mertpalabiyik/trotten-motorized/docs/images/button-caps.png

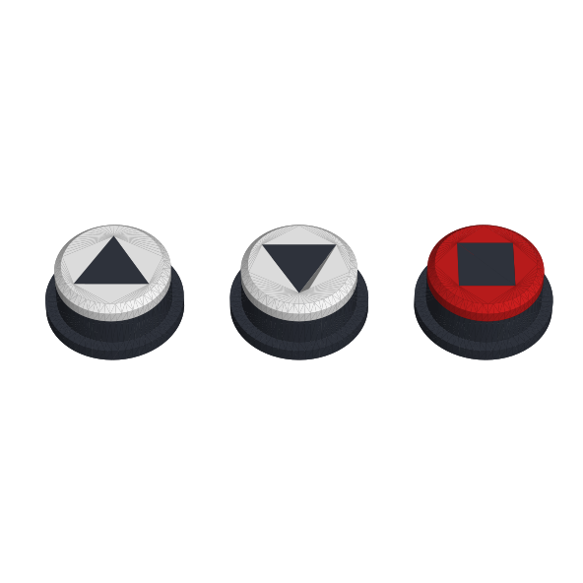
docs/images/button-caps.png
