mertpalabiyik/trotten-motorized/docs/images/coupler.png

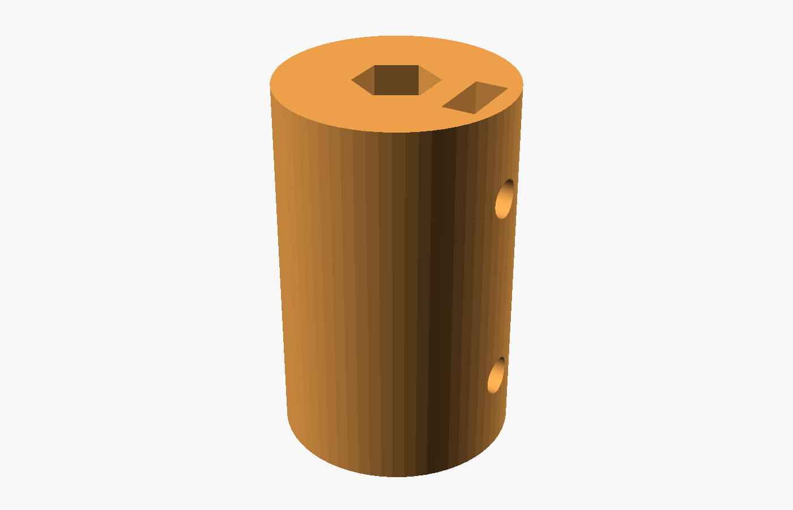
docs/images/coupler.png
