mertpalabiyik/trotten-motorized/docs/images/cover.png

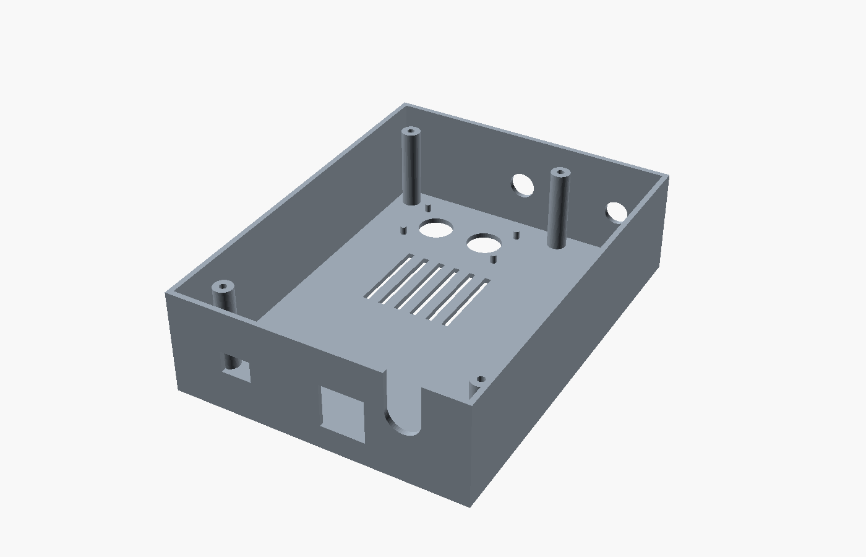
docs/images/cover.png
