mertpalabiyik/trotten-motorized/docs/images/hcsr04-spacer.png

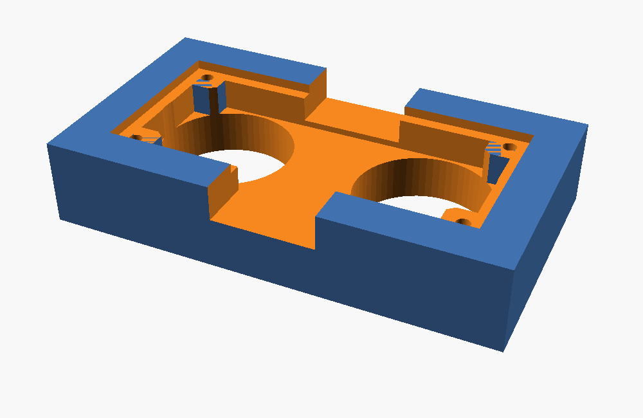
docs/images/hcsr04-spacer.png
