mertpalabiyik/trotten-motorized/cad/main-box/cover.stl

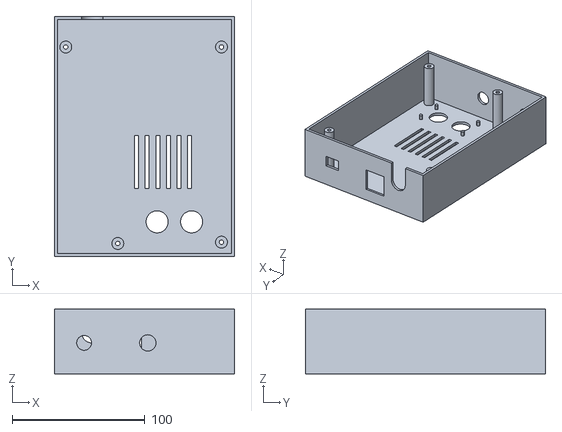
[picture p12: CAD file, 2026-10-15]
cad/main-box/cover.stl
135.8 x 180.8 x 48.9
