mertpalabiyik/trotten-motorized/cad/original/Body1.stl

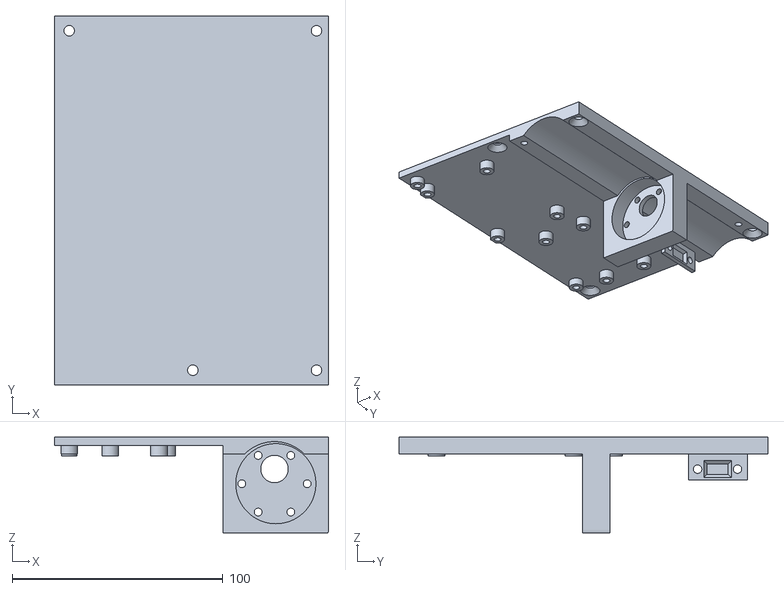
[picture p13: CAD file, 2026-10-14]
cad/original/Body1.stl
130.0 x 175.0 x 45.3
