mertpalabiyik/trotten-motorized/cad/panel/ams/button-caps-top-arrows.stl

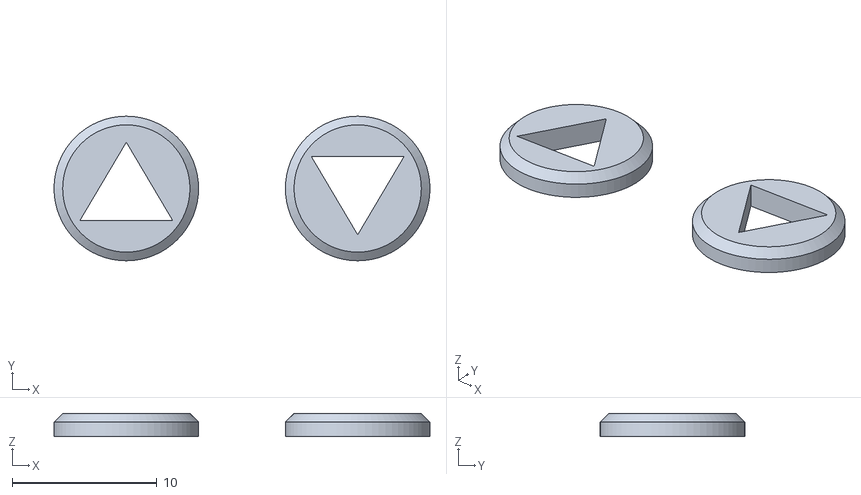
[picture p14: CAD file, 2026-10-14]
cad/panel/ams/button-caps-top-arrows.stl
26.0 x 10.0 x 1.60
