mertpalabiyik/trotten-motorized/cad/panel/panel-box.stl

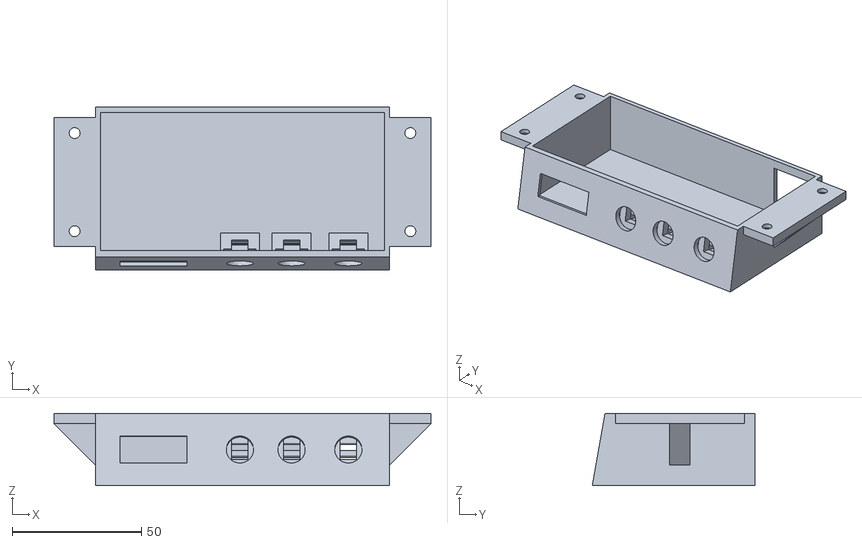
[picture p15: CAD file, 2026-10-15]
cad/panel/panel-box.stl
146.0 x 62.9 x 28.0
