mertpalabiyik/trotten-motorized/cad/main-box/coupler.stl

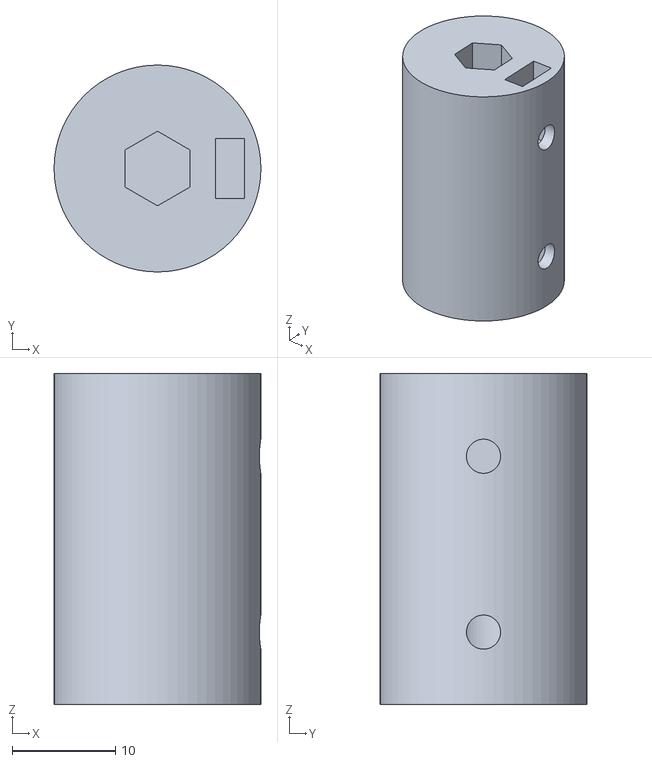
[picture p16: CAD file, 2026-10-14]
cad/main-box/coupler.stl
20.0 x 20.0 x 32.0
