mertpalabiyik/trotten-motorized/cad/panel/ams/button-caps-base.stl

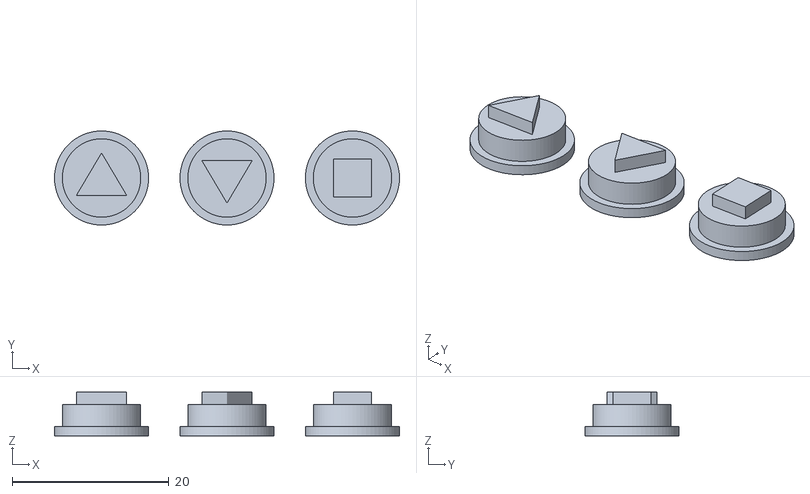
[picture p17: CAD file, 2026-10-14]
cad/panel/ams/button-caps-base.stl
44.0 x 12.0 x 5.60
