mertpalabiyik/trotten-motorized/cad/panel/button-caps-AMS.3mf

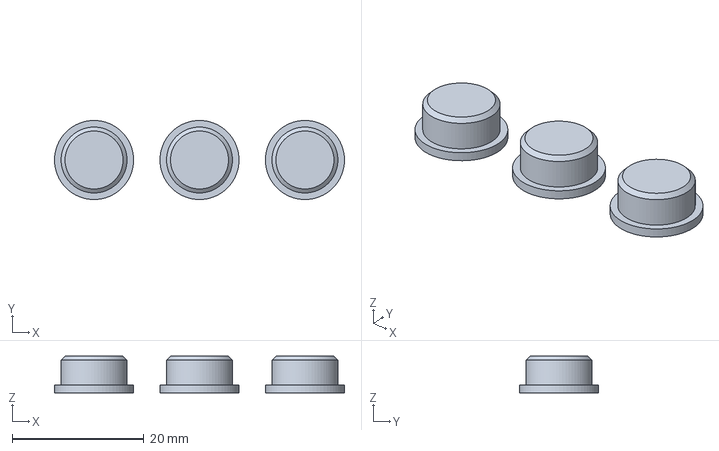
[picture p18: CAD file, 2026-10-14]
cad/panel/button-caps-AMS.3mf
44.0 x 12.0 x 5.60 mm
