mertpalabiyik/trotten-motorized/cad/main-box/hcsr04-spacer.stl

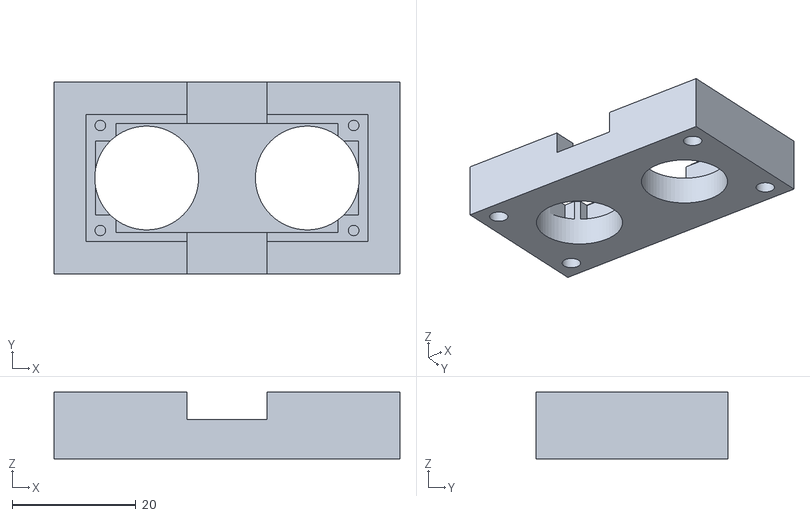
[picture p19: CAD file, 2026-10-14]
cad/main-box/hcsr04-spacer.stl
56.0 x 31.0 x 10.8
