mertpalabiyik/trotten-motorized/cad/panel/ams/button-caps-top-stop.stl

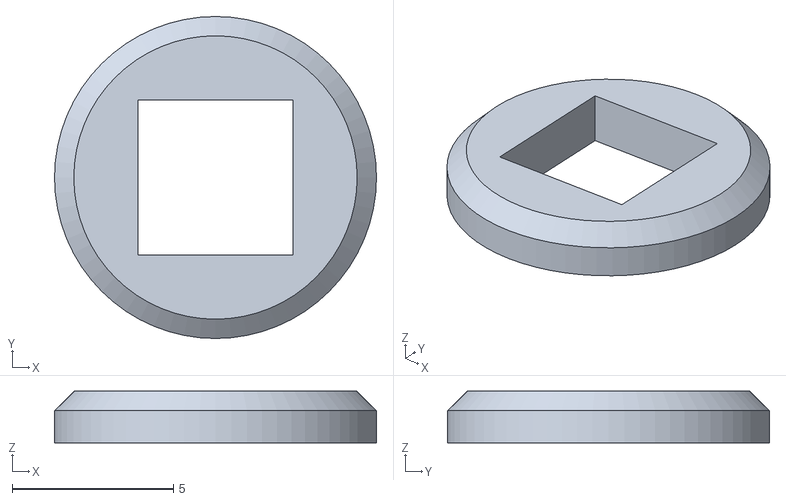
[picture p20: CAD file, 2026-10-14]
cad/panel/ams/button-caps-top-stop.stl
10.0 x 10.0 x 1.60
