mertpalabiyik/trotten-motorized/cad/panel/button-caps-single-color.stl

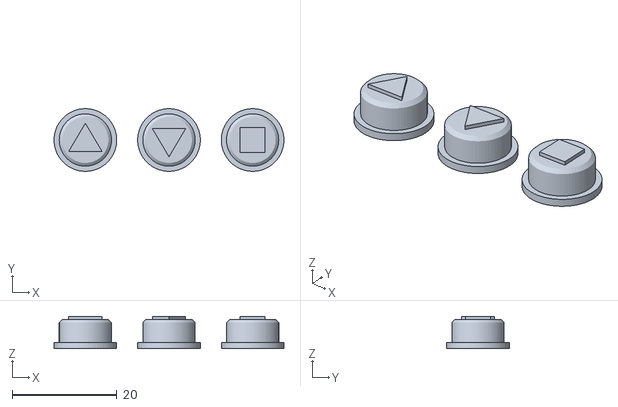
[picture p21: CAD file, 2026-10-14]
cad/panel/button-caps-single-color.stl
44.0 x 12.0 x 6.20
