mertpalabiyik/trotten-motorized/cad/main-box/body1-remix.stl

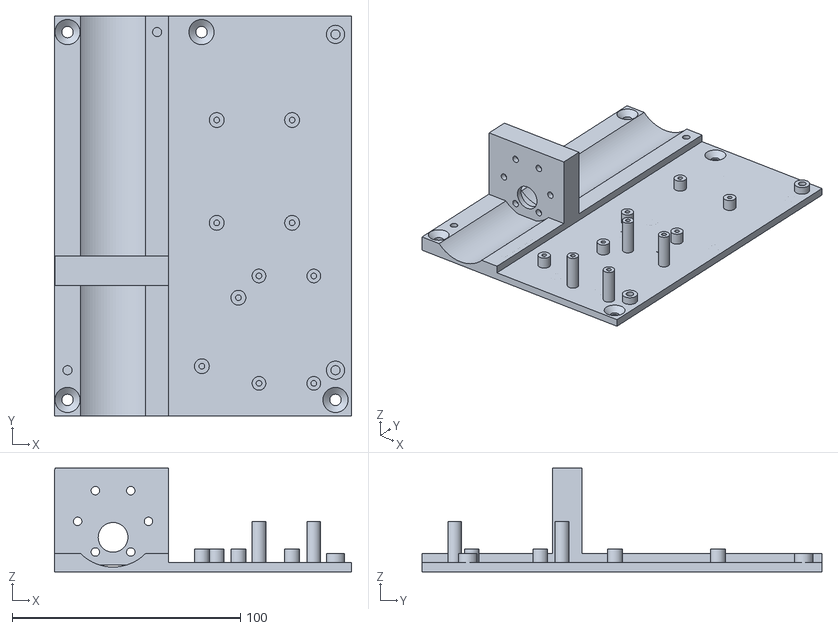
[picture p22: CAD file, 2026-10-14]
cad/main-box/body1-remix.stl
130.0 x 175.0 x 45.3
