mertpalabiyik/trotten-motorized/docs/guide-tr.html

IKEA TROTTEN · ESPHome · Home Assistant

# TROTTEN Motor Kiti

Manuel krankı 12V redüktörlü motorla değiştiriyoruz. Motor, kartlar ve sensör masanın arkasındaki tek bir kutuda. ESP32 iki röleyle motorun yönünü seçiyor, HC-SR04 yüksekliği ölçüyor, masa Home Assistant'ta tek bir cihaz olarak görünüyor.

Krank girişi: 6 mm altıgenMasa aralığı: ~72–122 cmBesleme: 12V tek adaptörButon paneli + OLED, HA olmadan da çalışır

## Parça listesi

Parça | Durum | Görevi
ESP32-WROOM DevKit (30 pin, USB-C) | Elinde | Beyin. WiFi ile HA'ya bağlanır. 4 köşe deliğinden ayaklara vidalanır.
2'li röle modülü (JQC-3FF-S-Z, 5V bobin) | Elinde | Motor yönü. 10A kontak, H-köprü gibi bağlanır.
LM2596 HW-411 | Elinde | 12V → 5,0V. ESP32, röle bobinleri, HC-SR04.
HC-SR04 | Elinde | Masa yüksekliği.
10k direnç × 3 | Elinde | ECHO hattı için 5V → 3,3V bölücü. Tek tane varsa 10k pot kullan.
4A sigorta + yuva | Elinde | 12V hattının hemen başına.
37GB555 12V redüktörlü motor | Elinde | Krankın yerine döner.
12V adaptör (en az 3A, ideal 5A) | Kontrol et | Tek güç kaynağı.
6×7 mm esnek kaplin (D19L25) | Alınacak | Motor mili ile altıgen çubuğu birleştirir.
6 mm alyan anahtarı | Kes | Düz kısmından yaklaşık 6 cm kesilir: kaplinden çıkıp krank yuvasına girer.
body1-revize.stl, kapak-revize.stl | Yazdır | Motor, kartlar ve sensör tek kutuda. pashiran'ın Body1'inden uyarlandı.
M3 sıcak gömme insert × 4 | Alınacak | Body1'deki kapak vidası delikleri.
Vidalar | Alınacak | M3×8 × 6 (motor), M3×12 × 4 (kapak), M3 veya M2.5×6 × 10 (kartlar), 4×16 ahşap vidası × 4 (tabla).
Wago 221 klemens: 3'lü × 1, 5'li × 1 | Alınacak | 12V ve GND dağıtımı. Yerine klemens bloğu da olur.
Panel tipi sigorta yuvası (5×20, 12 mm gövde) | Alınacak | Kapağın arka duvarına somunla takılır, sigorta dışarıdan kapağı açmadan değişir.
Panel tipi DC jak (DC-022, 5,5×2,1, 11 mm gövde) | Alınacak | Adaptör girişi, sigortanın yanında.
Dişi-dişi jumper seti, makaron | Kontrol et | ESP32 pinleri, bölücü dirençleri.
0,91" OLED (SSD1306, 128×32, I2C) | Elinde | Panelde yükseklik ve durum gösterir.
6×6 mm tactile switch (4 bacaklı, ~5 mm boy) × 3 | Elinde | ▲, ▼ ve ■ DUR. Panelin içindeki yuvalara oturur.
Buton başlıkları (iki renk) | Yazdır | 3 başlık (▲ ▼ ■), altlarındaki yuvayla switch'in siyah çubuğuna oturur. AMS'li yazıcıda buton-basligi-AMS.3mf (renkler atanmış) ya da buton-taban / ust_yon / ust_dur.stl: taban ve işaretler 1. renk, ▲▼ üstü 2. renk, ■ üstü 3. renk, tek renkli yazıcıda buton-basligi-kabartma.stl: 5,6 mm'de duraklat, filamenti değiştir.
RJ45 keystone jack (Cat5e/Cat6) × 2 | Alınacak | Biri ana kutunun kapağına, biri panel kutusunun arka duvarına takılır.
Düz (straight) patch kablo, ~1–1,5 m | Kontrol et | Kutu ile panel arası. İki uç da sökülüp takılabilir.
Kısa renkli damarlar (eski ethernet kablosundan) | Kontrol et | Keystone ile ESP32 / panel arası, kutuların içinde.
panel-kutusu.stl | Yazdır | Masanın ön kenarının altına 4 ahşap vidasıyla (3,5×12) takılır.
Kablo: 1 mm² güç, jumper sinyal | Kontrol et | 12V ve motor hattı kalın olmalı.

Kenarda kalanlar: Nano, Uno, L298N, HW-307, 220R. L298N'yi motoru masa başında ilk denemek için kullanabilirsin.

## 1 · Güç dağıtımı

Tek 12V adaptör. Sigortadan sonra iki kola ayrılıyor: röle kontakları (motor gücü) ve LM2596 (elektronik).

12V5V3,3VGND

Önce LM2596'yı ayarla. Çıkışa hiçbir şey bağlamadan multimetreyle 5,0V'a getir. Fabrika ayarı genelde girişe yakındır ve ayarsız bağlanan ESP32 yanar. Ayardan sonra trimpota bir damla oje sür.

## 2 · Motor: iki röleyle H-köprü

Her röle motorun bir ucunu ya +12V'a ya GND'ye bağlar. İki röle aynı anda çekse bile kısa devre oluşmaz, motor sadece frenlenir.

Röle 1 | Röle 2 | Sonuç
Çekti | Bıraktı | Yukarı (A=+12V, B=GND)
Bıraktı | Çekti | Aşağı (A=GND, B=+12V)
Bıraktı | Bıraktı | Dur, iki uç GND'de (fren)
Çekti | Çekti | Dur, iki uç +12V'ta (fren)

### Röle modülü jumper ayarı

Jumper'lı 3'lü header'da bir GND ve iki VCC var (bazı kartlarda biri JD-VCC yazar). Jumper'ı çıkar ve multimetreyle ölç: 4'lü header'daki VCC ile bip öten pin sinyal VCC'sidir, buraya ESP32'nin 3V3'ü gider. Diğeri bobin VCC'sidir (JD-VCC), buraya 5V gider. Böylece 3,3V sinyal röleyi temiz bırakır. H/L jumper'ı varsa L konumunda kalsın.

Masa ters yöne gidiyorsa motorun iki kablosunu COM'lar arasında yer değiştir.

## 3 · Sinyal bağlantıları

ESP32'den rölelere, sensöre ve butonlara giden ince kablolar. Pin adları kartın üstündeki yazılardır (D26), parantez içindekiler YAML'daki karşılıklarıdır (GPIO26).

SinyalGND

### Bölücü: 10k + 10k ne işe yarıyor?

HC-SR04'ün ECHO çıkışı 5V verir, ESP32'nin pinleri ise en fazla 3,3V kaldırır. Üç direnç bu 5V'u düşürür: R1 ECHO ile D18 arasına seri girer; R2 ve R3 seri bağlanıp D18'den GND'ye gider. R2 + R3 birlikte 20k eder, elinde 20k direnç olmadığı için iki tane 10k kullanıyoruz.

D18 gerilimi = 5V × 20k / (10k + 20k) = 3,33V

## 4 · Kutu içinde yerleşim

Masanın altından bakış, kaplin tarafı üstte. Her pinin yanındaki numara, 5. bölümdeki kablo listesinin satırıdır: aynı numarayı taşıyan pinleri birbirine bağla. ESP32'nin pin sırası 30 pinli USB-C kartın gerçek dizilişidir. Kart bileşen yüzü yere bakacak şekilde durur. Panelin I2C hatları D21 (24) ve D22 (25) sol sütunun alt kısmında, çizimin dışında kalır.

Röle modülünün klemens ve header sırası üreticiye göre değişebilir; bağlarken kart üzerindeki yazılara bak. 4'lü header'daki GND boş kalır: optokuplör tarafı yalnızca VCC (3,3V) ve IN uçlarıyla çalışır.

## 4a · Kablolama: 12V güç ve motor

Aynı yerleşim, kablolar çizilmiş hâli. Önce bu çizimdeki 1–9 numaralı kalın kabloları bağla. Nokta olan yerler birleşme noktasıdır; noktasız kesişmeler birbirine değmez.

12VGNDMotor

## 4b · Kablolama: 5V, 3,3V ve sinyal

LM2596'yı 5,0V'a ayarladıktan sonra 10–21 numaralı ince kabloları bağla. R1 ECHO kablosunun üzerine, R2 ve R3 D18 ile GND arasına seri lehimlenir. Buton paneli bağlantıları (22–28) 6. bölümde.

5V3,3VGNDSinyal

## 5 · Kablo listesi

Bağlantıları bu sırayla yap: önce güç, sonra motor, en son sinyaller. Her adımdan sonra kısa devre için multimetreyle kontrol et.

# | Nereden | Nereye | Kablo | Not

12V güç
1 | DC jak + (orta pin) | Sigorta yuvası arka ucu | 1 mm² kırmızı | İkisi de kapağın arka duvarında. Lehimle, makaronla kapat.
2 | Sigorta yuvası yan ucu | Wago 12V (3'lü) | 1 mm² kırmızı | Kapak sökülebilsin diye bu kabloyu biraz uzun bırak.
3 | Wago 12V | Röle 1 NO ve Röle 2 NO | 1 mm² kırmızı | İki NO arasına kısa bir köprü kablo.
4 | Wago 12V | LM2596 IN+ | 0,5 mm² kırmızı | Lehim.
5 | DC jak − | Wago GND (5'li) | 1 mm² siyah
6 | Wago GND | Röle 1 NC ve Röle 2 NC | 1 mm² siyah | İki NC arasına kısa köprü.
7 | Wago GND | LM2596 IN− | 0,5 mm² siyah | Lehim.
Motor
8 | Motor ucu 1 | Röle 1 COM | 1 mm² | Masa ters giderse 8 ile 9'u yer değiştir.
9 | Motor ucu 2 | Röle 2 COM | 1 mm² | Motor uçlarına 100 nF seramik kondansatör lehimlemek ESP32'nin parazitten etkilenmesini azaltır.
5V ve 3,3V (LM2596'yı önce 5,0V'a ayarla)
10 | LM2596 OUT+ | ESP32 VIN | Jumper, turuncu | Bu hat bağlıyken ESP32'ye USB takma.
11 | LM2596 OUT+ | Röle bobin VCC (JD-VCC) | Jumper, turuncu | 3'lü header'da 4'lü header VCC'siyle bağlantısı olmayan VCC pini. Jumper çıkarılmış olmalı.
12 | LM2596 OUT+ | HC-SR04 VCC | Jumper, turuncu, ~25 cm | Kapak sökülebilsin diye ara konnektörlü.
13 | LM2596 OUT− | ESP32 GND | Jumper, siyah | LM2596'nın IN− ve OUT− uçları kart üzerinde ortaktır.
14 | LM2596 OUT− | Röle GND (3'lü header'daki) | Jumper, siyah
15 | LM2596 OUT− | HC-SR04 GND | Jumper, siyah, ~25 cm | Bölücünün alt ucu da buraya.
16 | ESP32 3V3 | Röle VCC (IN1/IN2 yanındaki) | Jumper, sarı | Optokuplör tarafı 3,3V ile çalışır.
Sinyaller
17 | ESP32 D26 | Röle IN1 | Jumper, mavi | Yukarı
18 | ESP32 D27 | Röle IN2 | Jumper, yeşil | Aşağı
19 | ESP32 D5 | HC-SR04 TRIG | Jumper, beyaz, ~25 cm
20 | HC-SR04 ECHO | R1 (10k seri) → ESP32 D18 | Jumper, mor, ~25 cm | Direnç kabloya seri lehimlenir, makaronla kapatılır.
21 | ESP32 D18 | R2 + R3 (2 × 10k seri) → ESP32 GND (3V3 yanındaki) | Kısa jumper | Bölücünün GND kolu. D18 pininde ~3,3V oluşturur.
22–28 | Buton paneli: 6. bölüm

### Bölücüyü nasıl yaparım

HC-SR04'ün ECHO kablosunu ortadan kes, araya bir 10k direnç lehimle, makaronla kapat. ESP32 tarafındaki uca ikinci bir kablo ekle; bu kablo seri iki 10k direnç üzerinden GND'ye gider. Elinde tek 10k varsa 10k potansiyometre ile aynı işi yap ve orta uçta 3,3V'u ayarla.

### Kapak sökülebilir kalsın

HC-SR04'e giden dört kabloyu kapak çıkarılabilecek uzunlukta bırak ve araya 4 pinli bir dupont ara konnektör koy. Kapağı sökerken sensörü bu noktadan ayırırsın.

## 6 · Buton paneli

Masanın ön kenarının altına takılan küçük panel: 0,91" ekran ve üç buton. Ana kutuya iki RJ45 keystone ve düz bir patch kabloyla bağlanır; kablo iki uçtan da sökülebilir. Masayı Home Assistant'tan bağımsız kullanırsın; HA kapalıyken veya WiFi yokken de çalışır.

### Butonlar

▲ / ▼ kısa bas: masa en üste / en alta kadar gider.
▲ / ▼ basılı tut: tuttuğun sürece gider, bırakınca durur.
Hareket ederken herhangi bir tuş: durur.
■ DUR: her durumda anında durdurur.

### Ekran

Üstte büyük puntoyla yükseklik (cm) ve hareket oku. Altta: hareket sırasında hedef yükseklik, dururken "HA BAGLI" / "HA YOK", DUR'a basınca 2 saniye "DURDU".

# | ESP32 | Renk (T568B pin) | Panelde | Not

22 | 3V3 | Turuncu (2) | OLED VCC | 3V3 pininde röle VCC kablosu (16) da var: ikisini bir Y jumper ya da küçük bir Wago ile birleştir.
23 | GND (VIN yanındaki) | Turuncu-beyaz (1) + Yeşil-beyaz (3) | OLED GND ve üç butonun diğer ucu | İki damarı iki uçta da birlikte bağla. Panelde butonların ikinci uçlarını birbirine köprüle.
24 | D21 (GPIO21) | Yeşil (6) | OLED SDA | GND ile aynı bükümlü çiftte, I2C için iyi.
25 | D22 (GPIO22) | Mavi (4) | OLED SCL
26 | D25 (GPIO25) | Mavi-beyaz (5) | ■ DUR
27 | D32 (GPIO32) | Kahverengi (8) | ▲ YUKARI
28 | D33 (GPIO33) | Kahverengi-beyaz (7) | ▼ AŞAĞI

Keystone'ları T568B renk etiketine göre zımbala (her iki uçta aynı). Düz patch kablo renkleri uçtan uca korur; böylece keystone'un arkasından ESP32'ye ve panele giden kısa damarlar tablodaki renklerle aynı kalır.

### Panel kutusunu takmak

Ön yüzün üst kenarını masanın ön kenarıyla hizala; yüz 10° yukarı baktığı için otururken okunur. Yan kanatlardan 4 adet 3,5×12 ahşap vidasıyla tablaya vidala. Panelin düz arka duvarındaki keystone deliğine (sağ uçta, DUR butonunun arkasında; jack gövdesi kutunun içinde kalır) ve ana kutunun kapağındaki ön deliğe birer keystone jack tak. İkisini düz bir patch kabloyla bağla; kablo panelin arkasından çıkar.

### Butonları yerleştirmek

Önce başlığı, sonra 6×6 switch'i kutunun açık üstünden yuvasına kaydır: başlık ön delikten dışarı çıkar, flanşı duvarın iç yüzüne dayanır; switch arkadaki çubuğa yaslanır ve siyah çubuğu başlığın altındaki yuvaya girer. Bir damla sıcak silikonla sabitle. 4 bacağın ikişer ikişer içeriden bağlı olduğunu unutma: çapraz iki bacağı kullan, biri sinyal kablosuna, diğeri GND'ye. Switch'in boyu 5 mm değilse panel-kutusu.scad dosyasında sw_yukseklik değerini ölçtüğün boya göre değiştir; yoksa buton basılı kalır ya da boşlukta oynar.

### Ekranı yerleştirmek

OLED'i içeriden cebine, pinleri butonlara bakacak şekilde yerleştir; görünen alan pencereye denk gelir. Kenarlarından sıcak silikonla sabitle, camın ön yüzüne silikon sürme. Pencere ekran merkezine tam oturmazsa .scad dosyasında pencere_x değerini değiştir.

## Pin tablosu

ESP32 | Bağlandığı yer | Not
5V / VIN | LM2596 OUT+ | USB ile yükleme yaparken bu hattı ayır.
3V3 | Röle modülü VCC | 3'lü header'daki VCC–VCC jumper'ı çıkarılmış olmalı.
GND | Ortak GND | Hepsi aynı noktada birleşir.
D26 (GPIO26) | Röle IN1 | Yukarı
D27 (GPIO27) | Röle IN2 | Aşağı
D5 (GPIO5) | HC-SR04 TRIG | Doğrudan bağlanır.
D18 (GPIO18) | HC-SR04 ECHO | R1 seri; D18 → R2 + R3 → GND.
D21 (GPIO21) | Panel OLED SDA | I2C, 100 kHz.
D22 (GPIO22) | Panel OLED SCL
D25 (GPIO25) | Panel ■ DUR | İç pull-up açık.
D32 (GPIO32) | Panel ▲ YUKARI | İç pull-up açık.
D33 (GPIO33) | Panel ▼ AŞAĞI | İç pull-up açık.

## Kurulum sırası

### LM2596'yı 5,0V'a ayarla

1. Girişe 12V ver, çıkışta yük yokken multimetreyle ayarla.

### ESPHome'u USB ile yükle

2. HA'da ESPHome Builder'da yeni cihaz oluştur, aşağıdaki YAML'ı yapıştır, ilk yüklemeyi USB ile yap. Sonrakiler WiFi üzerinden gider.

### Röleleri motorsuz test et

3. Röle modülünü bağla, motoru takma. HA'dan yukarı ve aşağıya bas, her rölenin "tık" diye çekip durdurunca bıraktığını duy. Açılışta röle çekiyorsa YAML'da inverted: true satırlarını sil.

### Sensörü bağla ve monte et

4. Bölücüyle bağla, tablanın altına yere dik bakacak şekilde vidala. Altında sandalye, ayak veya kablo olmasın. Loglarda yükseklik değeri akmalı.

### Kalibre et

5. Masayı bir yükseklikte bırak, yerden tabla üstüne kadar ölç. Logdaki değerle farkı offset satırına yaz. En alt ve en üst konumları ölçüp min_h ve max_h'yi düzelt.

### Kutuyu monte et

6. Body1'deki 4 deliğe M3 insertleri havya ile göm. Motoru 6 adet M3×8 ile ön plakaya vidala, kartları ayaklarına bağla, kablolamayı listedeki sırayla yap. Body1'i altıgen çubuk krank yuvasına girecek şekilde tablaya vidala, kapağı alttan 4 adet M3×12 ile kapat. İlk çalıştırmada kısa basışlarla yönü kontrol et.

### Buton panelini bağla

7. Panel kutusunu masanın ön kenarına vidala, kabloyu 6. bölümdeki renklere göre iki uçta da bağla. Açılışta ekranda yükseklik görünmeli; ▲ / ▼ ve DUR'u motor bağlıyken kısa basışlarla dene.

### Güvenlik süresini ayarla

8. En alttan en üste bir turun süresini ölç. YAML'daki delay: 40s değerini bu sürenin biraz üstüne çek.

## ESPHome yapılandırması

YAML'ı kopyala

Röle sürümü, üç ayarlanabilir kademe, HA'da masa kontrolü, buton paneli ve OLED ekran. HA veya WiFi koparsa cihaz yeniden başlamaz, panelden çalışmaya devam eder. Kademeler HA'dan değiştirilir ve elektrik kesilse de kaybolmaz.

esphome:
  name: trotten-masa
  friendly_name: Trotten Masa

esp32:
  board: esp32dev
  framework:
    type: arduino

logger:

# Home Assistant ve WiFi olmadan da çalışsın: bağlantı kopunca yeniden başlatma
api:
  encryption:
    key: !secret api_key
  reboot_timeout: 0s
ota:
  - platform: esphome
    password: !secret ota_password
wifi:
  ssid: !secret wifi_ssid
  password: !secret wifi_password
  reboot_timeout: 0s

substitutions:
  min_h: "72.0"      # en alt (cm) – kendi masanda ölç
  max_h: "122.0"     # en üst (cm)

globals:
  - id: target_h
    type: float
    initial_value: "0"
  - id: dir          # 1 yukarı, -1 aşağı, 0 duruyor
    type: int
    initial_value: "0"
  - id: basma_ms     # panel tuşuna basıldığı an
    type: uint32_t
    initial_value: "0"
  - id: basildi_hareket   # tuşa basıldığında masa zaten hareket ediyor muydu
    type: bool
    initial_value: "false"
  - id: mesaj
    type: std::string
    initial_value: '""'
  - id: mesaj_ms
    type: uint32_t
    initial_value: "0"

# ---------- Röleler (JQC-3FF-S-Z, LOW'da çeker) ----------
output:
  - platform: gpio
    pin: { number: GPIO26, inverted: true }
    id: relay_a
  - platform: gpio
    pin: { number: GPIO27, inverted: true }
    id: relay_b

# ---------- Yükseklik sensörü ----------
sensor:
  - platform: ultrasonic
    trigger_pin: GPIO5
    echo_pin: GPIO18           # R1 + R2/R3 bölücüden geliyor
    name: "Masa Yüksekliği"
    id: height
    update_interval: 100ms
    timeout: 3m
    unit_of_measurement: "cm"
    accuracy_decimals: 1
    filters:
      - multiply: 100          # m -> cm
      - offset: 0.0            # kalibrasyon farkı
      - lambda: |-
          if (x < 50 || x > 150) return {};
          return x;
      - median:
          window_size: 5
          send_every: 1

# ---------- Kademeler (HA'dan ayarlanır, hafızada kalır) ----------
number:
  - platform: template
    name: "Kademe 1"
    id: k1
    min_value: ${min_h}
    max_value: ${max_h}
    step: 0.5
    unit_of_measurement: "cm"
    optimistic: true
    restore_value: true
    initial_value: 74
  - platform: template
    name: "Kademe 2"
    id: k2
    min_value: ${min_h}
    max_value: ${max_h}
    step: 0.5
    unit_of_measurement: "cm"
    optimistic: true
    restore_value: true
    initial_value: 95
  - platform: template
    name: "Kademe 3"
    id: k3
    min_value: ${min_h}
    max_value: ${max_h}
    step: 0.5
    unit_of_measurement: "cm"
    optimistic: true
    restore_value: true
    initial_value: 112

button:
  - platform: template
    name: "Kademe 1'e git"
    on_press:
      - lambda: id(move_to).execute(id(k1).state);
  - platform: template
    name: "Kademe 2'ye git"
    on_press:
      - lambda: id(move_to).execute(id(k2).state);
  - platform: template
    name: "Kademe 3'e git"
    on_press:
      - lambda: id(move_to).execute(id(k3).state);

# ---------- Motor kontrolü ----------
script:
  - id: move_to
    parameters:
      h: float
    then:
      - lambda: |-
          float cur = id(height).state;
          if (isnan(cur)) return;
          id(target_h) = h;
          if (h > cur + 0.5) id(go_up).execute();
          else if (h < cur - 0.5) id(go_down).execute();
  - id: go_up
    mode: restart
    then:
      - script.stop: go_down
      - output.turn_off: relay_b
      - delay: 50ms
      - lambda: id(dir) = 1;
      - output.turn_on: relay_a
      - delay: 40s             # güvenlik süresi
      - script.execute: motor_stop
  - id: go_down
    mode: restart
    then:
      - script.stop: go_up
      - output.turn_off: relay_a
      - delay: 50ms
      - lambda: id(dir) = -1;
      - output.turn_on: relay_b
      - delay: 40s
      - script.execute: motor_stop
  - id: motor_stop
    then:
      - script.stop: go_up
      - script.stop: go_down
      - output.turn_off: relay_a
      - output.turn_off: relay_b
      - lambda: id(dir) = 0;
  - id: goster          # ekranın alt satırında 2 sn mesaj
    parameters:
      m: string
    then:
      - lambda: |-
          id(mesaj) = m;
          id(mesaj_ms) = millis();

interval:
  - interval: 50ms
    then:
      - lambda: |-
          float h = id(height).state;
          if (isnan(h) || id(dir) == 0) return;
          if (id(dir) == 1  && (h >= id(target_h) || h >= ${max_h})) id(motor_stop).execute();
          if (id(dir) == -1 && (h <= id(target_h) || h <= ${min_h})) id(motor_stop).execute();

# ---------- HA'da masa ----------
cover:
  - platform: template
    name: "Masa"
    has_position: true
    lambda: |-
      float h = id(height).state;
      if (isnan(h)) return {};
      float p = (h - ${min_h}) / (${max_h} - ${min_h});
      return clamp(p, 0.0f, 1.0f);
    open_action:
      - lambda: id(move_to).execute(${max_h});
    close_action:
      - lambda: id(move_to).execute(${min_h});
    stop_action:
      - script.execute: motor_stop
    position_action:
      - lambda: id(move_to).execute(${min_h} + pos * (${max_h} - ${min_h}));

# ---------- Buton paneli ----------
# ▲ / ▼ kısa bas: en üste / en alta kadar gider (DUR'a ya da herhangi bir tuşa basınca durur)
# ▲ / ▼ basılı tut: tuttuğun sürece gider, bırakınca durur
# ■ DUR: her durumda anında durdurur
binary_sensor:
  - platform: status
    id: ha_bagli

  - platform: gpio
    id: tus_yukari
    name: "Panel Yukarı"
    pin: { number: GPIO32, mode: INPUT_PULLUP, inverted: true }
    filters:
      - delayed_on_off: 25ms
    on_press:
      - lambda: |-
          id(basma_ms) = millis();
          id(basildi_hareket) = id(dir) != 0;
          if (id(basildi_hareket)) { id(motor_stop).execute(); return; }
          id(target_h) = ${max_h};
          id(go_up).execute();
    on_release:
      - lambda: |-
          if (!id(basildi_hareket) && millis() - id(basma_ms) > 400) id(motor_stop).execute();

  - platform: gpio
    id: tus_asagi
    name: "Panel Aşağı"
    pin: { number: GPIO33, mode: INPUT_PULLUP, inverted: true }
    filters:
      - delayed_on_off: 25ms
    on_press:
      - lambda: |-
          id(basma_ms) = millis();
          id(basildi_hareket) = id(dir) != 0;
          if (id(basildi_hareket)) { id(motor_stop).execute(); return; }
          id(target_h) = ${min_h};
          id(go_down).execute();
    on_release:
      - lambda: |-
          if (!id(basildi_hareket) && millis() - id(basma_ms) > 400) id(motor_stop).execute();

  - platform: gpio
    id: tus_dur
    name: "Panel Dur"
    pin: { number: GPIO25, mode: INPUT_PULLUP, inverted: true }
    filters:
      - delayed_on: 25ms
    on_press:
      - script.execute: motor_stop
      - lambda: id(goster).execute("DURDU");

# ---------- OLED 0,91" 128x32 ----------
i2c:
  sda: GPIO21
  scl: GPIO22
  frequency: 100kHz          # panel kablosu ~1 m, düşük hız daha güvenli

font:
  - file: "gfonts://Roboto Condensed@700"
    id: buyuk
    size: 22
    glyphs: "0123456789.-"
  - file: "gfonts://Roboto Condensed"
    id: kucuk
    size: 10
    glyphs: " 0123456789.-:cmABCDEFGHIJKLMNOPRSTUVYZ"

display:
  - platform: ssd1306_i2c
    model: "SSD1306 128x32"
    address: 0x3C
    update_interval: 200ms
    lambda: |-
      float h = id(height).state;
      // üst satır: büyük yükseklik
      if (isnan(h)) it.print(0, -2, id(buyuk), "--.-");
      else          it.printf(0, -2, id(buyuk), "%.1f", h);
      it.print(64, 9, id(kucuk), "cm");
      // sağ üst: hareket oku
      if (id(dir) == 1)  it.filled_triangle(110, 18, 127, 18, 118, 2);
      if (id(dir) == -1) it.filled_triangle(110, 2, 127, 2, 118, 18);
      // alt satır: geçici mesaj, yoksa hedef / bağlantı durumu
      if (millis() - id(mesaj_ms) < 2000 && !id(mesaj).empty()) {
        it.print(0, 21, id(kucuk), id(mesaj).c_str());
      } else if (id(dir) != 0) {
        it.printf(0, 21, id(kucuk), "HEDEF %.0f", id(target_h));
      } else {
        it.print(0, 21, id(kucuk), id(ha_bagli).state ? "HA BAGLI" : "HA YOK");
      }

## Sorun çıkarsa

Belirti | Çözüm
Röle bırakmıyor | 3'lü header'daki VCC–VCC jumper'ı çıkarılmış mı, sinyal VCC'si 3V3'te, bobin VCC'si 5V'ta mı kontrol et. İki VCC'yi ters bağladıysan yer değiştir.
Açılışta masa kendi kendine hareket ediyor | Modül aktif-HIGH. YAML'da inverted: true satırlarını sil.
Masa ters yöne gidiyor | Motor kablolarını iki COM arasında yer değiştir.
Yükseklik zıplıyor | Sensörün altını boşalt, halı varsa altına sert bir yüzey koy.
Hedefi hep aynı yönde 0,5–1 cm kaçırıyor | interval içinde hedefe küçük bir pay ekle, ör. h >= id(target_h) - 0.7.
Panel ekranı boş kalıyor | Loglarda I2C taramasına bak: ekran 0x3D'de görünüyorsa YAML'da address satırını değiştir. SDA ile SCL'nin yer değiştirmediğini kontrol et.
Panel tuşu hep basılı görünüyor | Switch'in aynı taraftaki iki bacağını kullanmış olabilirsin; bunlar içeriden zaten bağlıdır. Çapraz bacakları kullan.
Panel tuşu kendiliğinden tetikleniyor | Kablo motor kablolarının yanından geçiyorsa ayır. Olmazsa YAML'da delayed_on_off süresini 50ms yap ya da tuş hattından 3V3'e 4,7k direnç ekle.
Sigorta atıyor | Mekanizma sıkışmış veya motor yükte zorlanıyor. Masayı elle krankla kontrol et.
