mertpalabiyik/trotten-motorized/docs/images/print-orientation.png

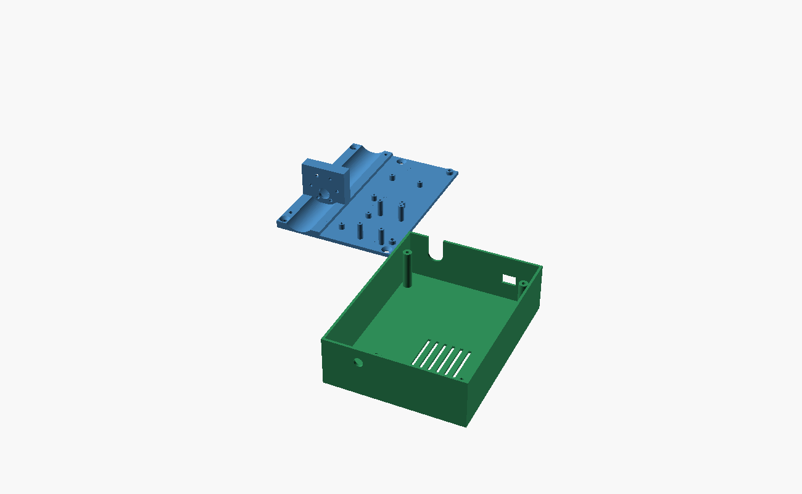
docs/images/print-orientation.png
