mertpalabiyik/trotten-motorized/(commit log)

2026-10-14 Add main box parts (base plate, cover, coupler, HC-SR04 spacer)
    [body1-remix.scad, body1-remix.stl, coupler.scad, coupler.stl, cover.scad, cover.stl, hcsr04-spacer.scad, hcsr04-spacer.stl]
2026-10-14 Add original Body1.stl by pashiran (remix source)
    [Body1.stl]
2026-10-14 Add front panel box and button caps
    [button-caps-AMS.3mf, button-caps-single-color.stl, button-caps.scad, panel-box.scad, panel-box.stl]
2026-10-14 Add multi-colour button cap bodies
    [button-caps-base.stl, button-caps-top-arrows.stl, button-caps-top-stop.stl]
2026-10-14 Add renders and wiring diagrams
2026-10-14 README: full bill of materials, SKARSTA support (EN/TR)
2026-10-15 Panel box: fit Digitus tool-less keystone (20x20x36), flush OLED glass
    [panel-box.scad, panel-box.stl]
2026-10-15 Cover: keystone hole for Digitus tool-less keystone (20x20)
    [cover.scad, cover.stl]
2026-10-15 Firmware: re-init OLED every 5 s so it never stays dark after a power dip
2026-10-15 README: power the OLED from 5 V (VIN)
